Joementrex/InstrumentedCube/Images/20240607_185310.jpg

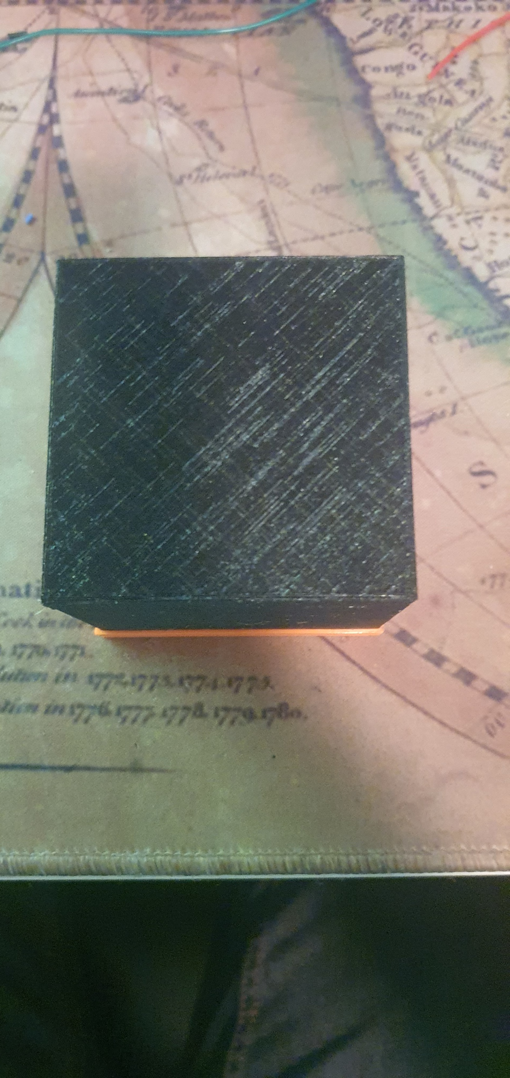
Images/20240607_185310.jpg
