Joementrex/InstrumentedCube/Images/20240607_211036.jpg

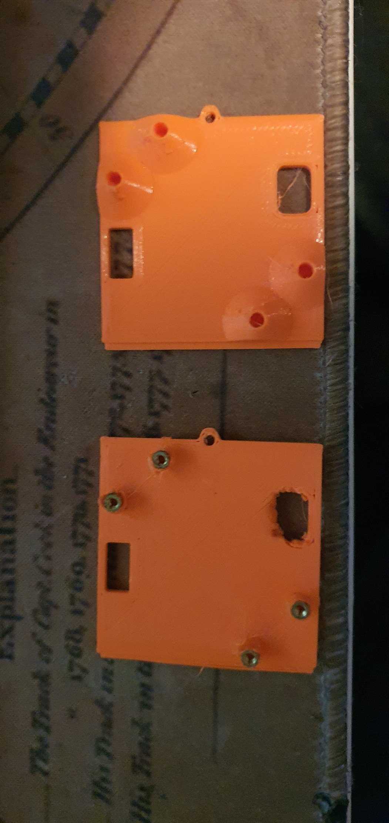
Images/20240607_211036.jpg
