Joementrex/InstrumentedCube/Images/Creality Ender3 V2 v4.png

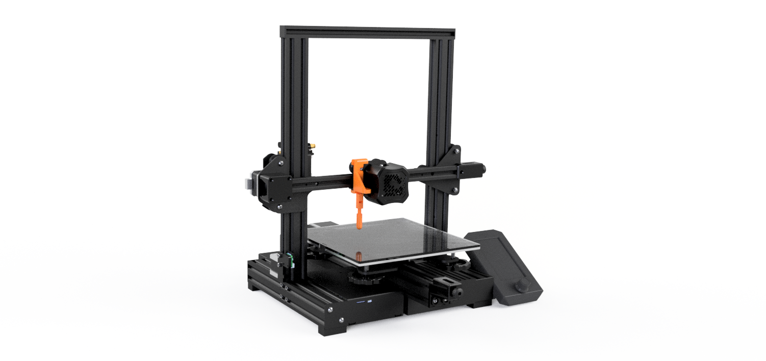
Images/Creality Ender3 V2 v4.png
