Joementrex/InstrumentedCube/Images/SmartSelect_20240607_202022_Gallery.jpg

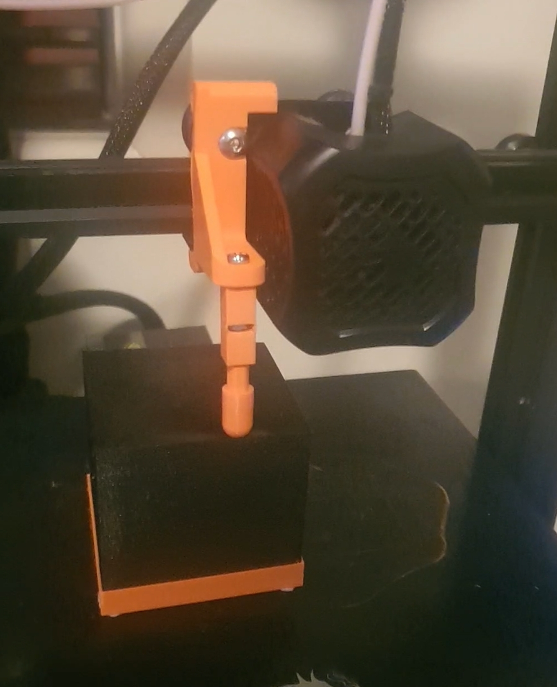
Images/SmartSelect_20240607_202022_Gallery.jpg
