Joementrex/InstrumentedCube/3D Files/InnerShell.stl

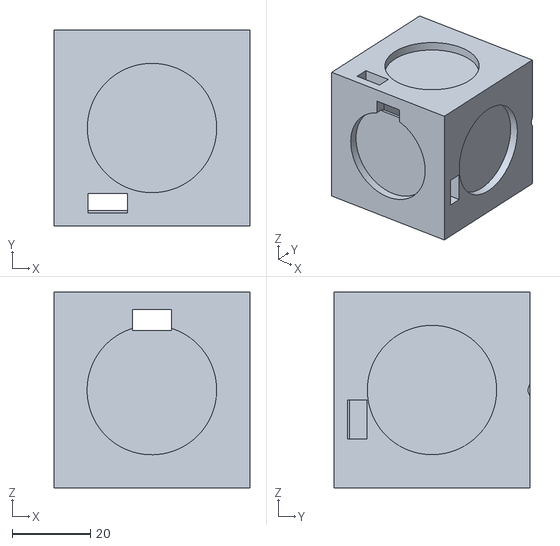
[picture p12: CAD file, 2024-06-20]
3D Files/InnerShell.stl
50.0 x 50.0 x 50.0
