Joementrex/InstrumentedCube/3D Files/Reciever Case Upper.stl

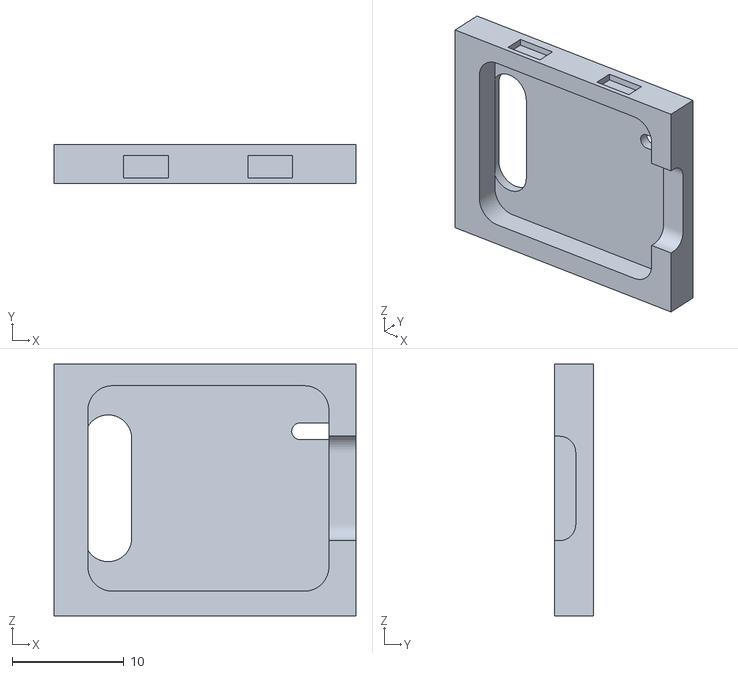
[picture p13: CAD file, 2024-06-20]
3D Files/Reciever Case Upper.stl
27.0 x 3.50 x 22.5
