Joementrex/InstrumentedCube/3D Files/Reciever Case Lower.stl

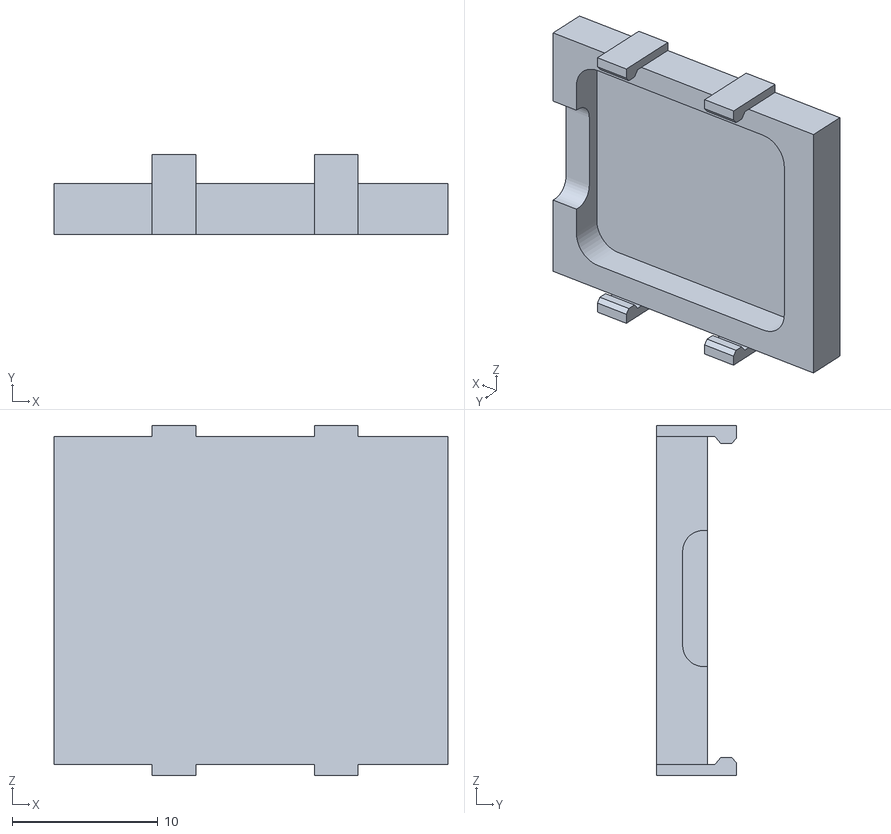
[picture p14: CAD file, 2024-06-20]
3D Files/Reciever Case Lower.stl
27.0 x 5.50 x 24.0
