Joementrex/InstrumentedCube/3D Files/InnerShell Lid.stl

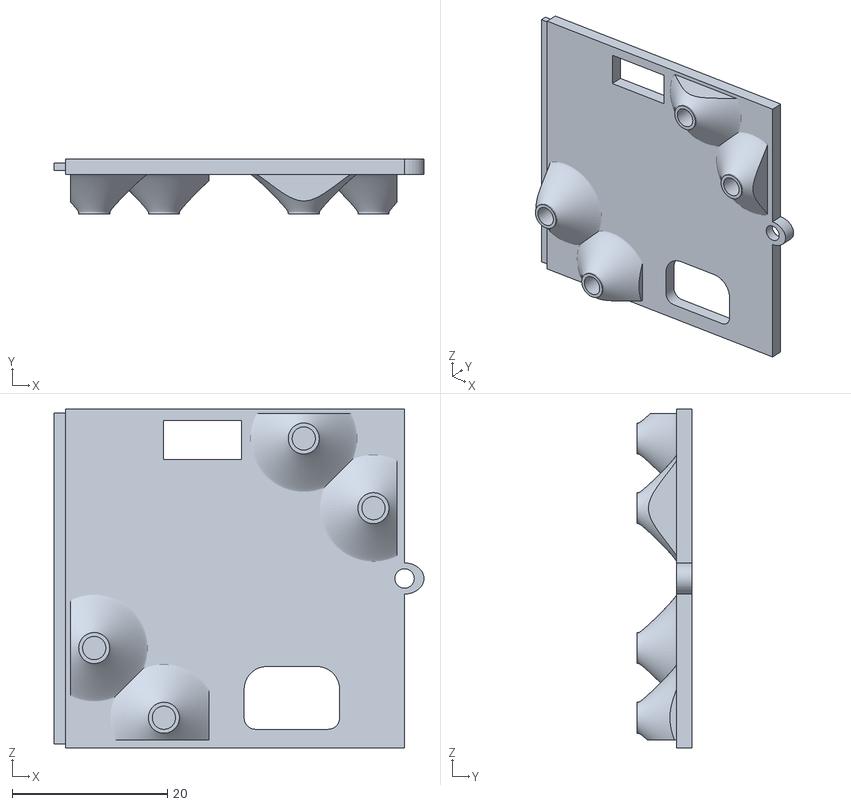
[picture p15: CAD file, 2024-06-20]
3D Files/InnerShell Lid.stl
47.6 x 7.09 x 43.6
