Joementrex/InstrumentedCube/3D Files/Probe Lock .stl

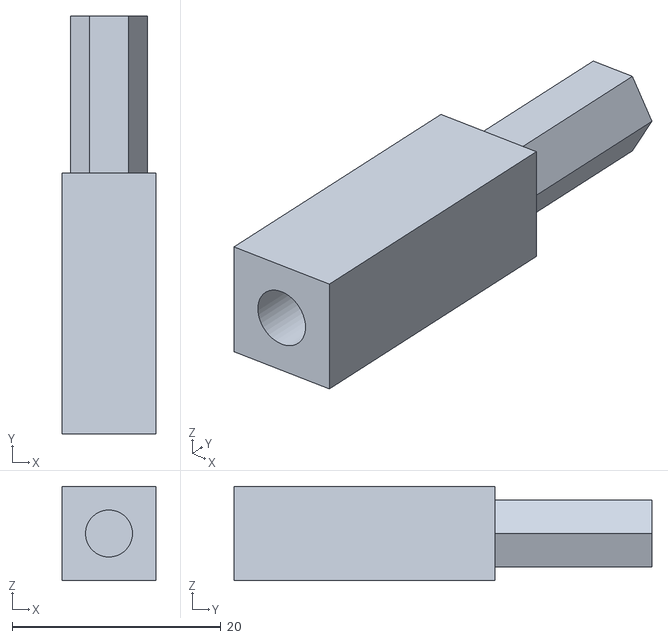
[picture p16: CAD file, 2024-06-20]
3D Files/Probe Lock .stl
9.00 x 40.0 x 9.00
