Joementrex/InstrumentedCube/3D Files/OuterShell.stl

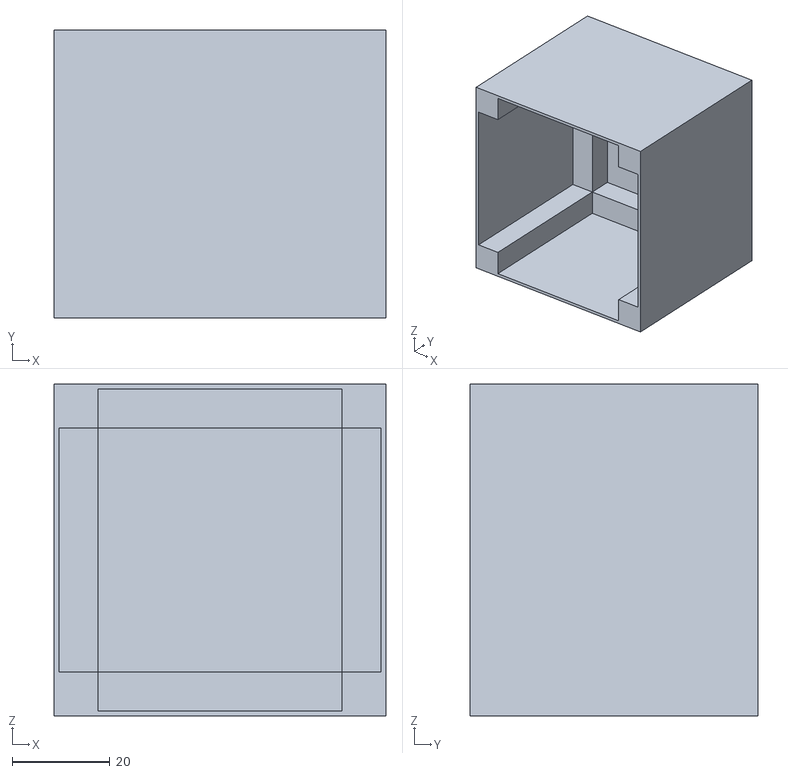
[picture p17: CAD file, 2024-06-20]
3D Files/OuterShell.stl
68.0 x 59.0 x 68.0
