Joementrex/InstrumentedCube/3D Files/Single Probe.stl

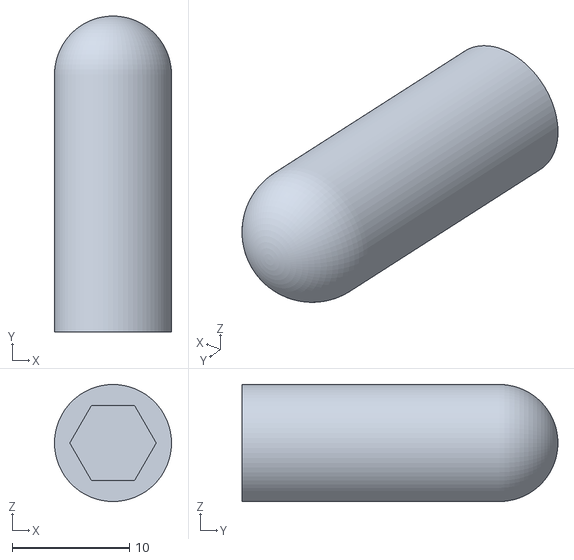
[picture p18: CAD file, 2024-06-20]
3D Files/Single Probe.stl
10.0 x 27.0 x 10.00
