Joementrex/InstrumentedCube/3D Files/Ender 3 V2 Probe Holder.stl

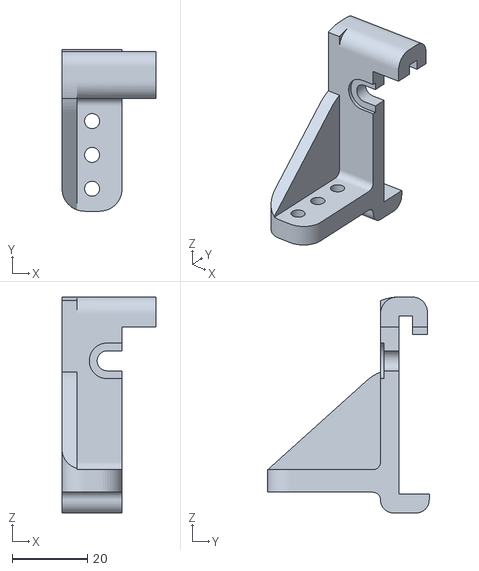
[picture p19: CAD file, 2024-06-20]
3D Files/Ender 3 V2 Probe Holder.stl
25.0 x 43.0 x 57.5
