Joementrex/InstrumentedCube/3D Files/Modules.stl

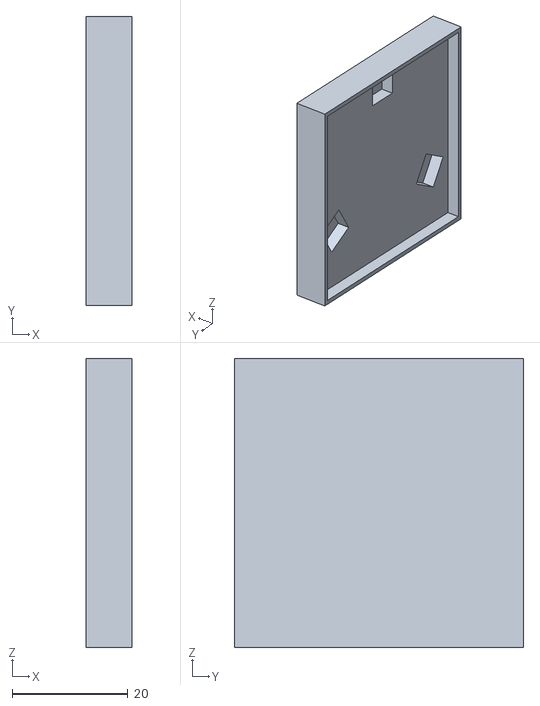
[picture p20: CAD file, 2024-06-20]
3D Files/Modules.stl
8.00 x 50.0 x 50.0
