Joementrex/InstrumentedCube/3D Files/Bottom Face .stl

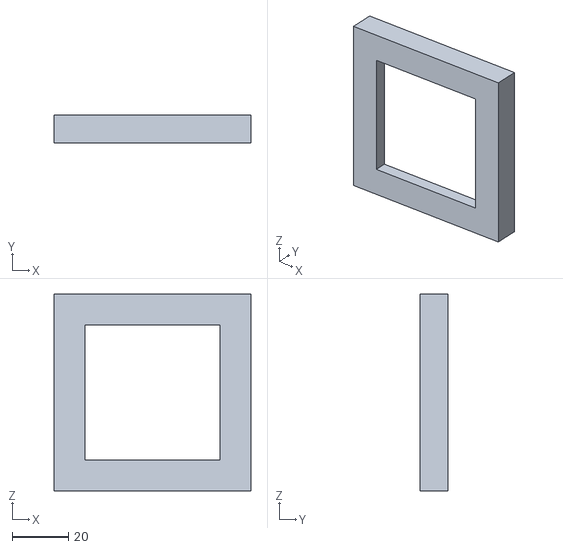
[picture p21: CAD file, 2024-06-20]
3D Files/Bottom Face .stl
70.0 x 10.00 x 70.0
