Joementrex/InstrumentedCube/Images/CubeAssembled.png

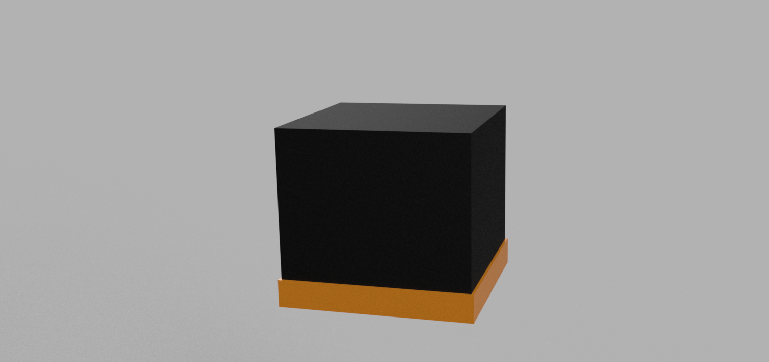
Images/CubeAssembled.png
