Joementrex/InstrumentedCube/Unsorted Files/TestData.csv

Face | Pos | Force | X1 | Y1 | Z1 | X2 | Y2 | Z2 | X3 | Y3 | Z3 | X4 | Y4 | Z4 | X5 | Y5 | Z5 | X6 | Y6 | Z6 | X7 | Y7 | Z7 | X8 | Y8 | Z8 | X9 | Y9 | Z9 | X10 | Y10 | Z10 | X11 | Y11 | Z11 | X12 | Y12 | Z12 | X13 | Y13 | Z13 | X14 | Y14 | Z14 | X15 | Y15 | Z15
0 | 0 | 0 | -385 | -7323 | -3124 | 736 | -6125 | -3326 | 774 | -4221 | -2159 | -568 | -6679 | -2048 | -314 | -4458 | -2408 | 1024 | -6434 | -3299 | 1087 | -5717 | -3594 | -220 | -4898 | -3687 | -507 | -6279 | -2478 | 649 | -5428 | -2639 | 293 | -4668 | -2774 | -826 | -6443 | -2289 | -722 | -6643 | -2556 | 524 | -4897 | -3443 | -689 | -5741 | -2775
0 | 0 | 0 | -401 | -7372 | -3092 | 718 | -6068 | -3321 | 796 | -4230 | -2162 | -579 | -6780 | -2198 | -326 | -4478 | -2389 | 1036 | -6366 | -3356 | 1099 | -5678 | -3584 | -213 | -4858 | -3636 | -535 | -6299 | -2418 | 652 | -5426 | -2640 | 259 | -4655 | -2784 | -829 | -6469 | -2267 | -727 | -6659 | -2595 | 525 | -4884 | -3599 | -692 | -5741 | -2811
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
