Joementrex/InstrumentedCube/PCB/TMAG5273A1_PCB_mini/TMAG5273A1_PCB_mini.kicad_sch

## KiCad design PCB/TMAG5273A1_PCB_mini/TMAG5273A1_PCB_mini.kicad_sch (2024-06-20)

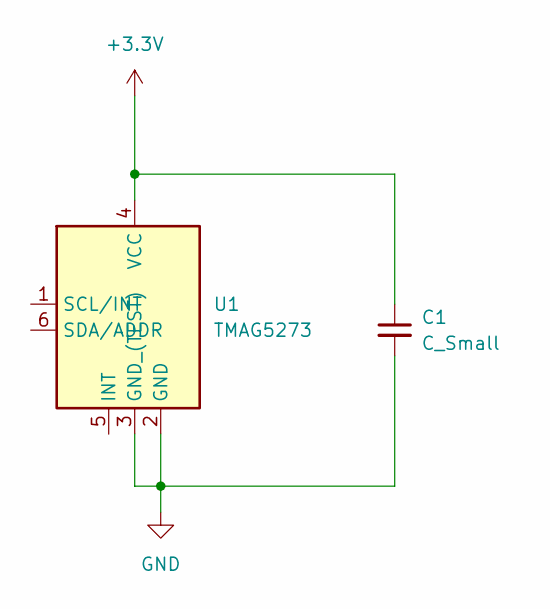
[picture p23: schematic TMAG5273A1_PCB_mini.kicad_sch]

Parts:
C1: C_Small; CP_Elec_3x5.3
U1: TMAG5273; SOT-23-6

Connections:
+3.3V: C1.1, U1.4 (VCC)
GND: C1.2, U1.2 (GND), U1.3 (GND_(TEST))
