Joementrex/InstrumentedCube/(commit log)

2024-06-07 Added microcontroller programs
    [configuration.h]
2024-06-20 Updated Files
    [Balanced.csv, Bottom Face .stl, Ender 3 V2 Probe Holder.stl, External_sensor_schematic.kicad_pcb, External_sensor_schematic.kicad_sch, InnerShell Lid.stl, InnerShell.stl, Modules.stl]
